astandev/Vibration_Detection_and_Classification_Project/Design Validation/pcb.jpg

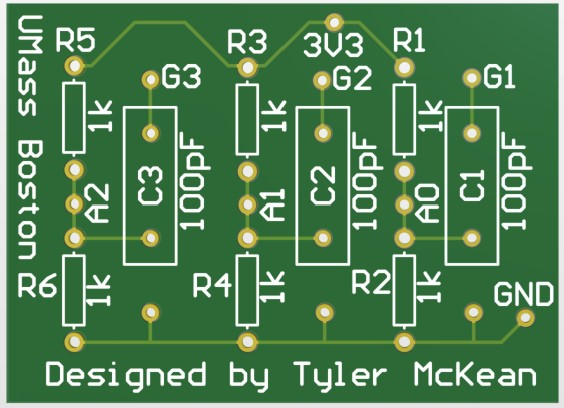
Design Validation/pcb.jpg
