astandev/Vibration_Detection_and_Classification_Project/Final Product Presentation/Final Budget.png

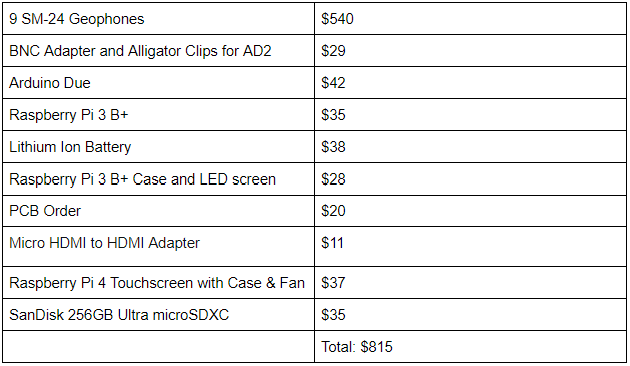
Final Product Presentation/Final Budget.png
