astandev/Vibration_Detection_and_Classification_Project/Project Poster/FeatureTable.png

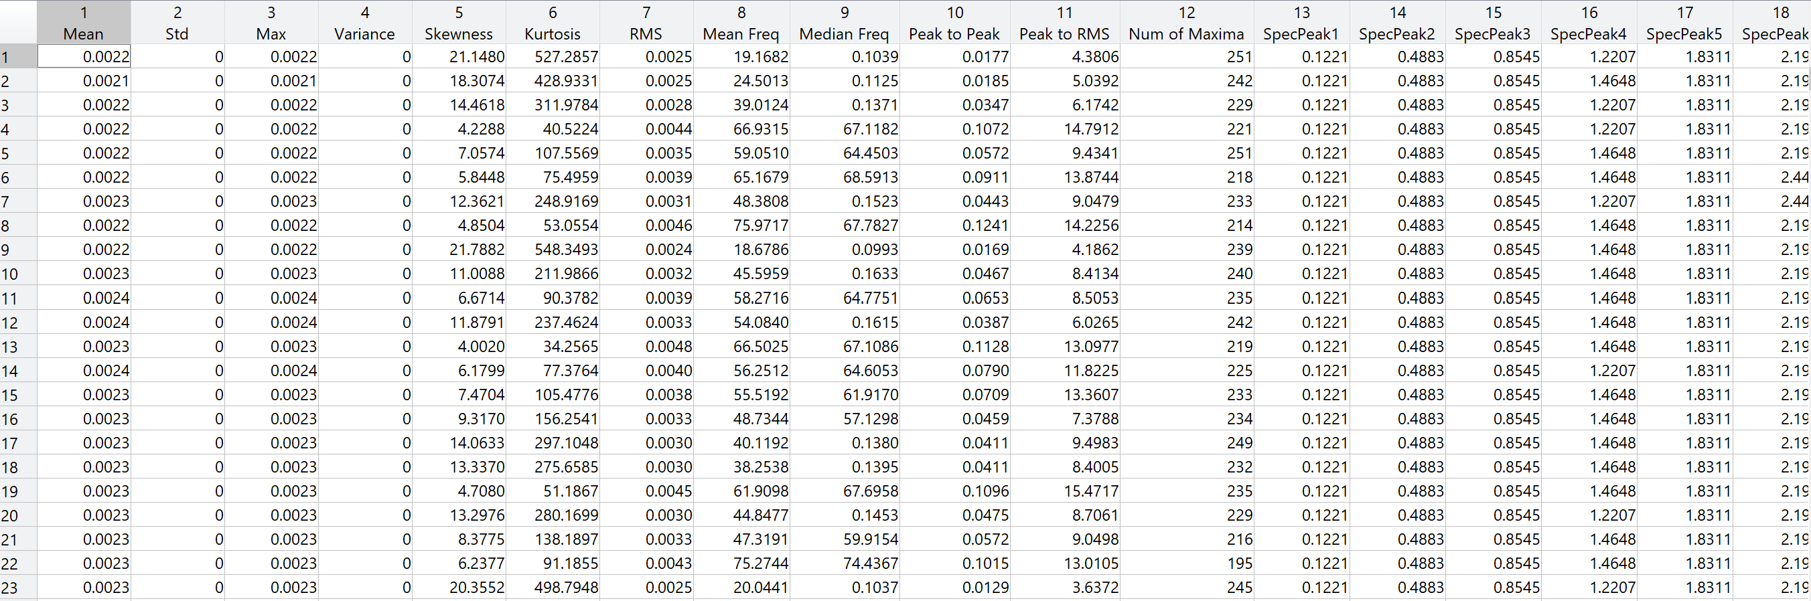
Project Poster/FeatureTable.png
