astandev/Vibration_Detection_and_Classification_Project/Project Poster/Flowchart Color.png

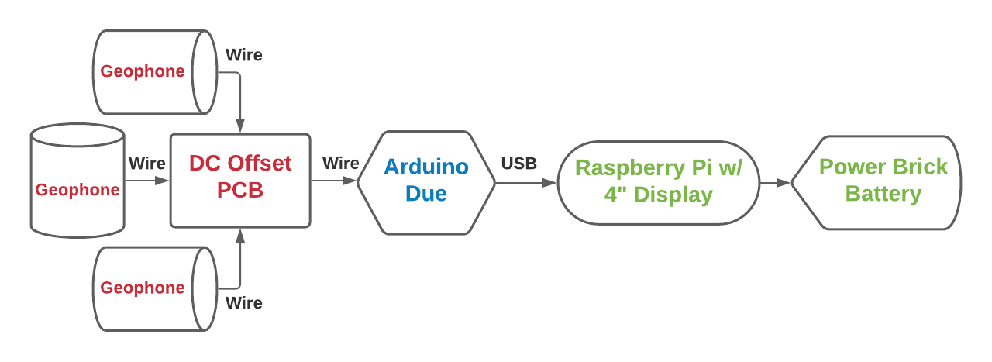
Project Poster/Flowchart Color.png
