astandev/Vibration_Detection_and_Classification_Project/Design Validation/DVR-1.pdf

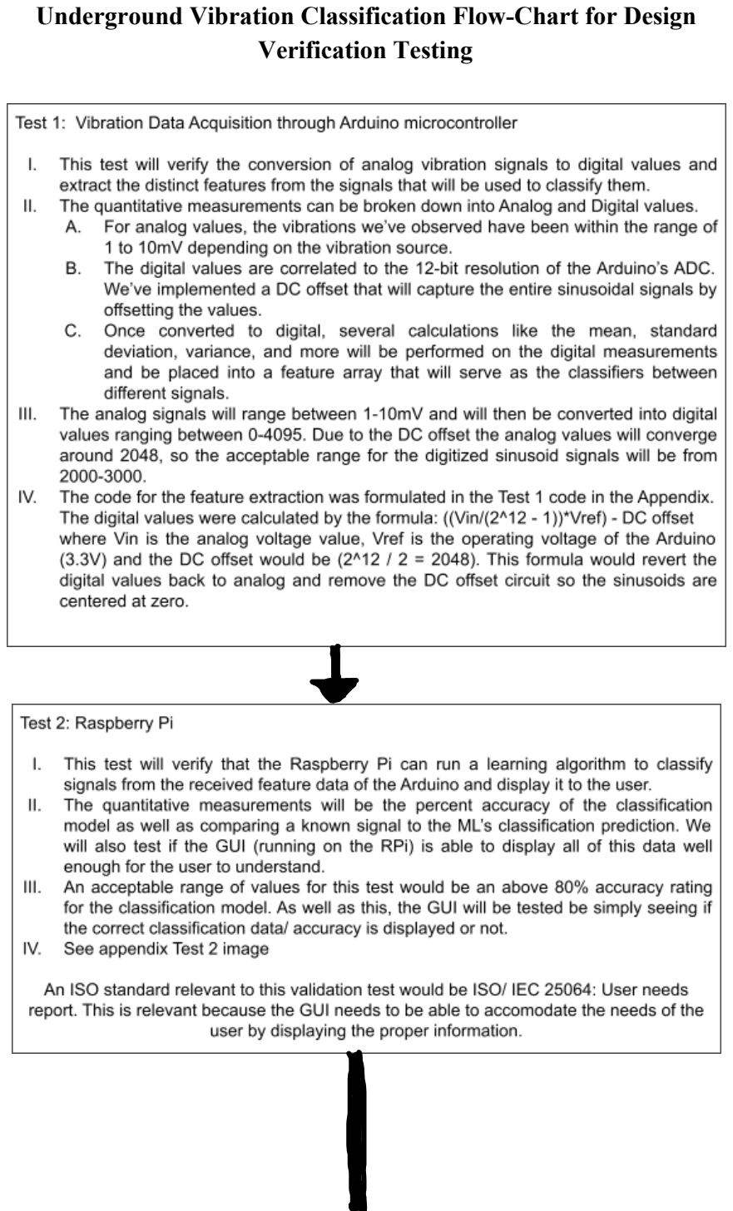
[picture p61: page 1]

### Underground Vibration Classification Flow-Chart for Design Verification Testing

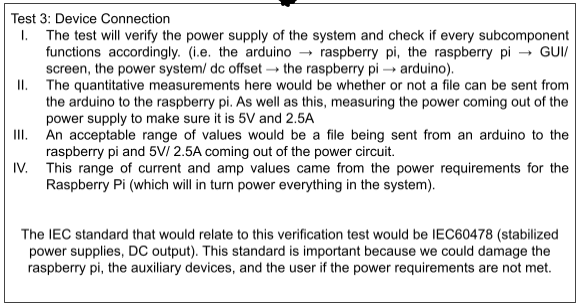
[picture p62: figure]

Test Reports:

Test 1:
To conduct the verification test for the data acquisition of the Arduino, my team and I plan on testing several days over Spring break. Ideally, Monday March 15th and Tuesday March 16th are the days we plan to conduct this test. The time of testing will be done around Noon in Tyler’s backyard. Since we have to conduct our tests outdoors, the weather conditions could alter our plans. We are hoping to be able to test during a sunny day in the early afternoon with reasonable temperature and humidity, so that we can plan to be outdoors testing for several hours. Tyler will be the operator for the test and will be conducting the classification algorithms predictions of vibrations signals. Beforehand, we will have obtained a whole signal library of different footsteps, shovel, and other vibration induced sources to train our classification algorithm. This test will involve obtaining new signals and running their extracted features through the classification algorithm and verifying how accurate its prediction is. Our group has specified that a classification accuracy of 70-80% is the benchmark we are striving for. Being able to reach this accuracy rate will vastly depend on how much data we use to train our model. So if we do not reach this accuracy for the verification test, we know we will have to continue training it until it gets close to this accuracy range.

Test 2:
The second test will be conducted in parallel/ after the verification of the first test. This test will happen over spring break, most likely in the lab space. The first step in this test will be testing the learning algorithm with a test set of data (obtained from the internet). The second step of testing will be testing the algorithm with our own obtained signals and comparing them to predictions in real time. This second part of the test will be conducted after test 1 is completed. We are hoping to already have trained a model that is above 80% accurate and to receive results that correctly identify the test signals to the right classification. This section of testing will be lead by Augustus.

Test 3:
The third test will be conducted over the Spring break once the first two verification tests have been verified. Ideally, we are going to aim for the weekend of March 20th and will test in Tyler’s backyard around Noon. To avoid any electrical-water damage, we hope to test during a sunny or cloudy afternoon. Either Tyler, Gus, or Vulindsky will be the operator of the test and we plan to connect the Arduino and Raspberry Pi to the power supply to verify that all components are powered and operating correctly. The arduino should obtain new vibration data, extract its features, and send these to the Raspberry pi to perform the classification algorithm on the data. The data will then be classified to some percentage of accuracy and displayed to the 3” GUI mounted to the GPIO of the Raspberry Pi. The GUI should be responsive whenever new vibration data is obtained. Once we verify that all the subcomponents are working, we will test how long the power supply can keep the system working correctly. We expect after some time, the battery will be drained and not enough power will be supplied to one of the subcomponents. This will cause accuracy of the vibration data to be more inconsistent and even possibly stop displaying data to the GUI.

### Appendix

Test 1 Code:
function feat = featureExtract(data)
% Extract features of vibrations into array % Initialize feature vector

feat = zeros(1,22);
fs = 5000;

% Average value in signal buffer for all three acceleration components (1 each) feat(1) = mean(data,1);

% RMS value in signal buffer for all three acceleration components (1 each) feat(2) = rms(data,1);

% Standard Deviation of vibration signal
feat(3) = std(data,1);

% Variance normalizes by N and produces the second moment of the % sample about its mean.
feat(4) = var(data,1);

% Mean Frequency estimates the mean frequency, FREQ, of the power
% spectrum of the time-domain signal in vector data with sample rate, Fs. feat(5) = meanfreq(data, fs);

% Median Frequency computes the median frequency, FREQ, of the power % spectrum of the time-domain signal in vector X with sample rate, Fs. feat(6) = medfreq(data, fs);

% Peak to Peak measures the difference between the largest
% and smallest element in data.
feat(7) = peak2peak(data);

% Peak to RMS measures the ratio between the largest absolute % value and root mean squared value in data.
feat(8) = peak2rms(data);

% Calculate the number of peaks in the vibration signal data feat(9) = numel(findpeaks(data,fs));

% Calculate the number of minimas in the vibration signal data feat(10) = numel(islocalmin(data,fs));

% Spectral peak features (12 each): height and position of first 6 peaks feat(11:22) = spectralPeaksFeatures(data,fs);

% Autocorrelation features for all three acceleration components (3 each): % height of main peak; height and position of second peak
feat(23:25) = autocorrFeatures(data, fs);

% Spectral power features (5 each): total power in 5 adjacent
% and pre-defined frequency bands
feat(26:30) = spectralPowerFeatures(data, fs);

% --- Helper functions
function feats = spectralPeaksFeatures(data, fs)

feats = zeros(1,12);
N = 4096;

mindist_xunits = 0.3;
minpkdist = floor(mindist_xunits/(fs/N));

% Cycle through number of channels
nfinalpeaks = 6;
for k = 1
[xpsd, f] = pwelch(data(:,k),rectwin(length(data)),[],N,fs);
[pks,locs] = findpeaks(xpsd,'npeaks',20,'minpeakdistance',minpkdist); opks = zeros(nfinalpeaks,1);
if(~isempty(pks))
mx = min(6,length(pks));
[spks, idx] = sort(pks,'descend'); slocs = locs(idx);

pkssel = spks(1:mx);
locssel = slocs(1:mx);

[olocs, idx] = sort(locssel,'ascend'); opks = pkssel(idx);
end
ofpk = f(olocs);

% Features 1-6 positions of highest 6 peaks feats(12*(k-1)+(1:length(opks))) = ofpk;
% Features 7-12 power levels of highest 6 peaks feats(12*(k-1)+(7:7+length(opks)-1)) = opks; end
function feats = autocorrFeatures(x, fs)

feats = zeros(1,3);

minprom = 0.0005;
mindist_xunits = 0.3;
minpkdist = floor(mindist_xunits/(1/fs));

% Separate peak analysis for 3 different channels for k = 1
[c, lags] = xcorr(x(:,k));

[pks,locs] = findpeaks(c,... 'minpeakprominence',minprom,... 'minpeakdistance',minpkdist);

tc = (1/fs)*lags;
tcl = tc(locs);

% Feature 1 - peak height at 0 if(~isempty(tcl)) % else f1 already 0
feats((k-1)+1) = pks((end+1)/2);
end
% Features 2 and 3 - position and height of first peak if(length(tcl) >= 3) % else f2,f3 already 0 feats((k-1)+2) = tcl((end+1)/2+1);
feats((k-1)+3) = pks((end+1)/2+1);
end
end

function feats = spectralPowerFeatures(x, fs)

edges = [0.5, 1.5, 5, 10, 15, 20];

[xpsd, f] = periodogram(x,[],4096,fs);

featstmp = zeros(5,1);

for kband = 1:length(edges)-1
featstmp(kband,:) = sum(xpsd( (f>=edges(kband)) & (f<edges(kband+1)), :),1); end
feats = featstmp(:);

Test 2 Image:

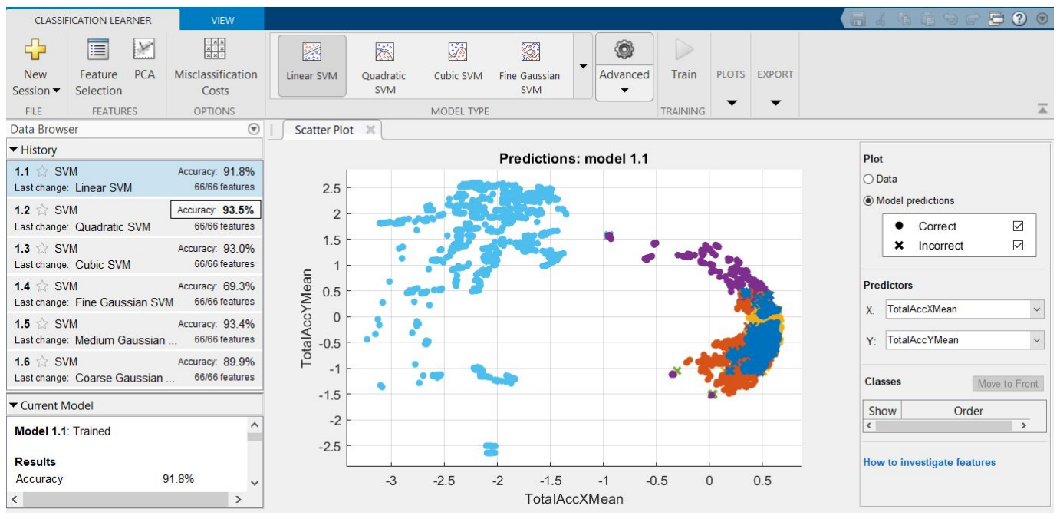
[picture p63: figure]
