astandev/Vibration_Detection_and_Classification_Project/Design Validation/Updated Budget.png

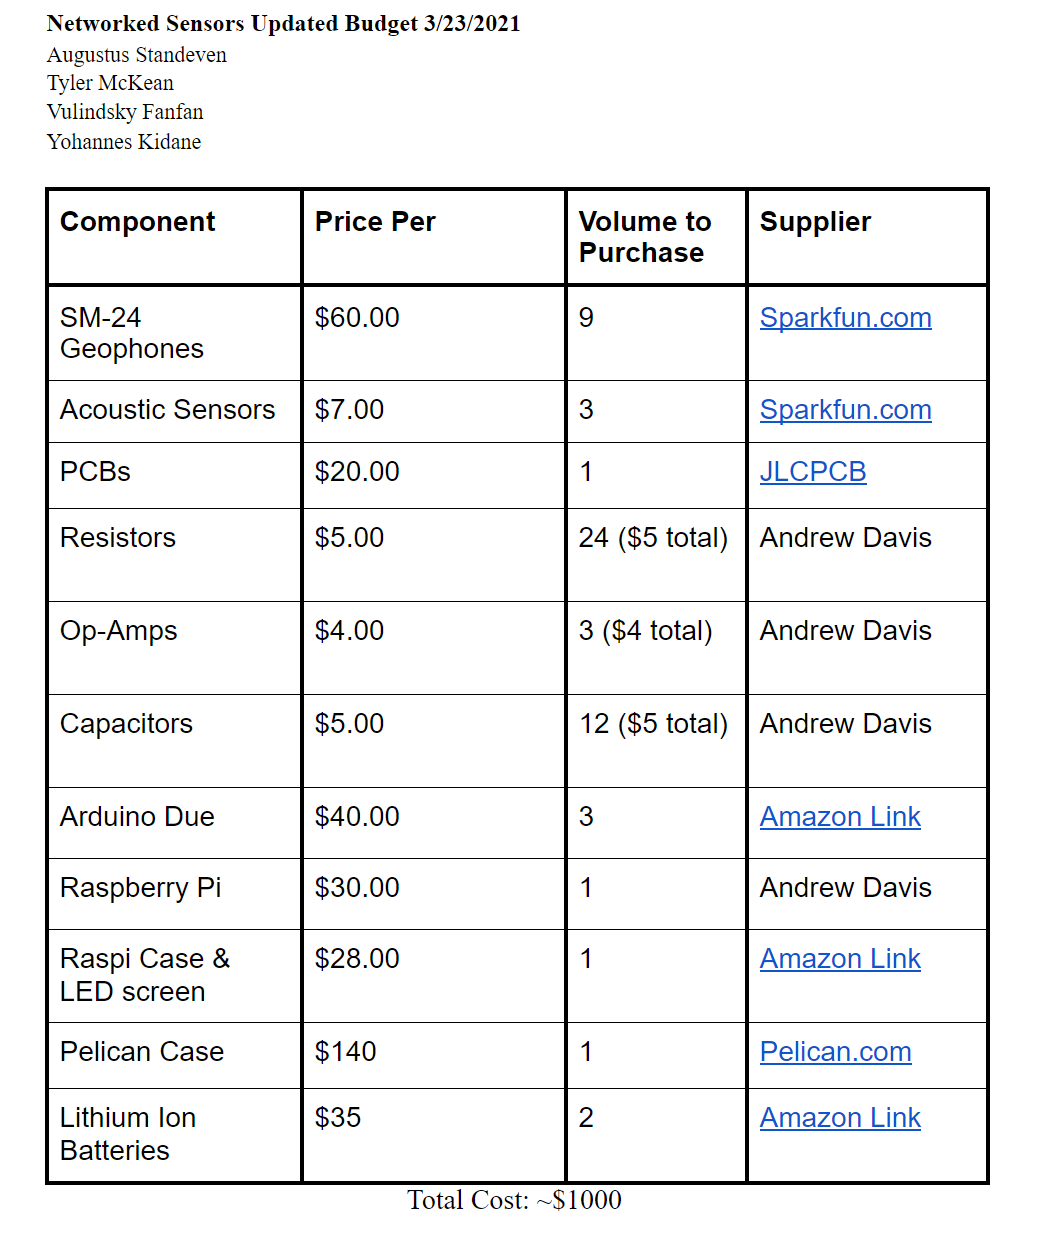
Design Validation/Updated Budget.png
