astandev/Vibration_Detection_and_Classification_Project/Raspberry Pi/History.txt

  -------Activity Detected -------
 Sencor-1 Prediction : RUNNING 
 Sencor-2 Prediction : JUMPING 
 Sencor-3 Prediction : RUNNING 
 Time =11:39:24:AM

  -------Activity Detected -------
 Sencor-1 Prediction : WEIGHT DROP 
 Sencor-2 Prediction : JUMPING 
 Sencor-3 Prediction : JUMPING 
 Time =11:39:24:AM

  -------Activity Detected -------
 Sencor-1 Prediction : RUNNING 
 Sencor-2 Prediction : JUMPING 
 Sencor-3 Prediction : JUMPING 
 Time =11:39:24:AM

  -------Activity Detected -------
 Sencor-1 Prediction : JUMPING 
 Sencor-2 Prediction : JUMPING 
 Sencor-3 Prediction : JUMPING 
 Time =11:39:24:AM

  -------Activity Detected -------
 Sencor-1 Prediction : JUMPING 
 Sencor-2 Prediction : JUMPING 
 Sencor-3 Prediction : JUMPING 
 Time =11:39:24:AM

  -------Activity Detected -------
 Sencor-1 Prediction : RUNNING 
 Sencor-2 Prediction : JUMPING 
 Sencor-3 Prediction : WEIGHT DROP 
 Time =11:43:12:AM

  -------Activity Detected -------
 Sencor-1 Prediction : WEIGHT DROP 
 Sencor-2 Prediction : JUMPING 
 Sencor-3 Prediction : JUMPING 
 Time =11:43:12:AM

  -------Activity Detected -------
 Sencor-1 Prediction : RUNNING 
 Sencor-2 Prediction : JUMPING 
 Sencor-3 Prediction : JUMPING 
 Time =11:43:12:AM

  -------Activity Detected -------
 Sencor-1 Prediction : WEIGHT DROP 
 Sencor-2 Prediction : JUMPING 
 Sencor-3 Prediction : JUMPING 
 Time =11:43:12:AM

  -------Activity Detected -------
 Sencor-1 Prediction : RUNNING 
 Sencor-2 Prediction : JUMPING 
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
 Sencor-1 Prediction : RUNNING 
 Sencor-2 Prediction : WALKING 
 Sencor-3 Prediction : WALKING 
 Time =12:11:20:PM

  -------Activity Detected -------
 Sencor-1 Prediction : RUNNING 
 Sencor-2 Prediction : RUNNING 
 Sencor-3 Prediction : RUNNING 
 Time =12:18:23:PM
