astandev/Vibration_Detection_and_Classification_Project/Design Validation/DVR Flowchart.pdf

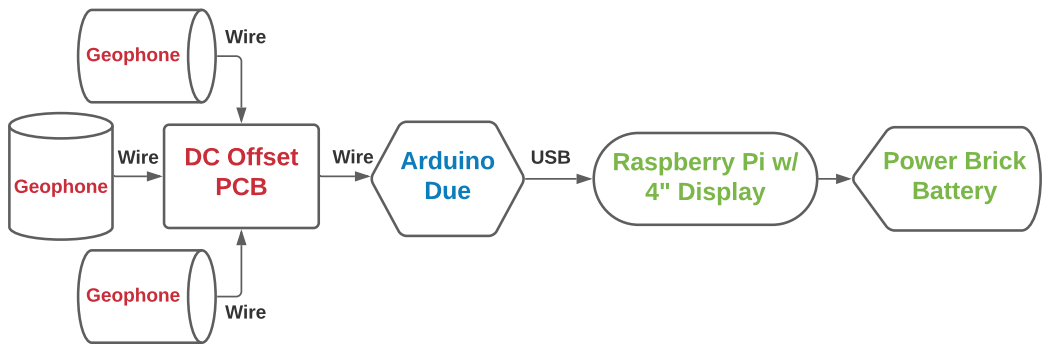
[picture p68: page 1]
Raspberry Pi w/ 4" Display; Power Brick Battery; DC Offset; USB; PCB; Geophone; Arduino Due; Wire
